Octave-Mechatronics/Sonar-Radar/arduino-sonar-radar/media/sonar_radar_pcb.png

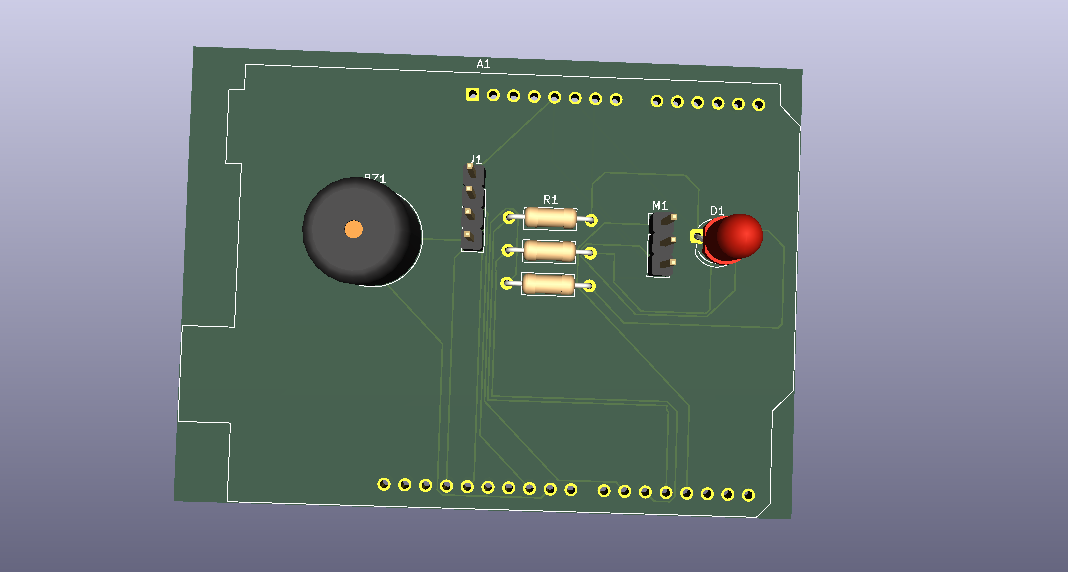
arduino-sonar-radar/media/sonar_radar_pcb.png
