Octave-Mechatronics/Sonar-Radar/sonar_radar_pcb.kicad_pcb

## KiCad design sonar_radar_pcb.kicad_pcb (2026-09-17)

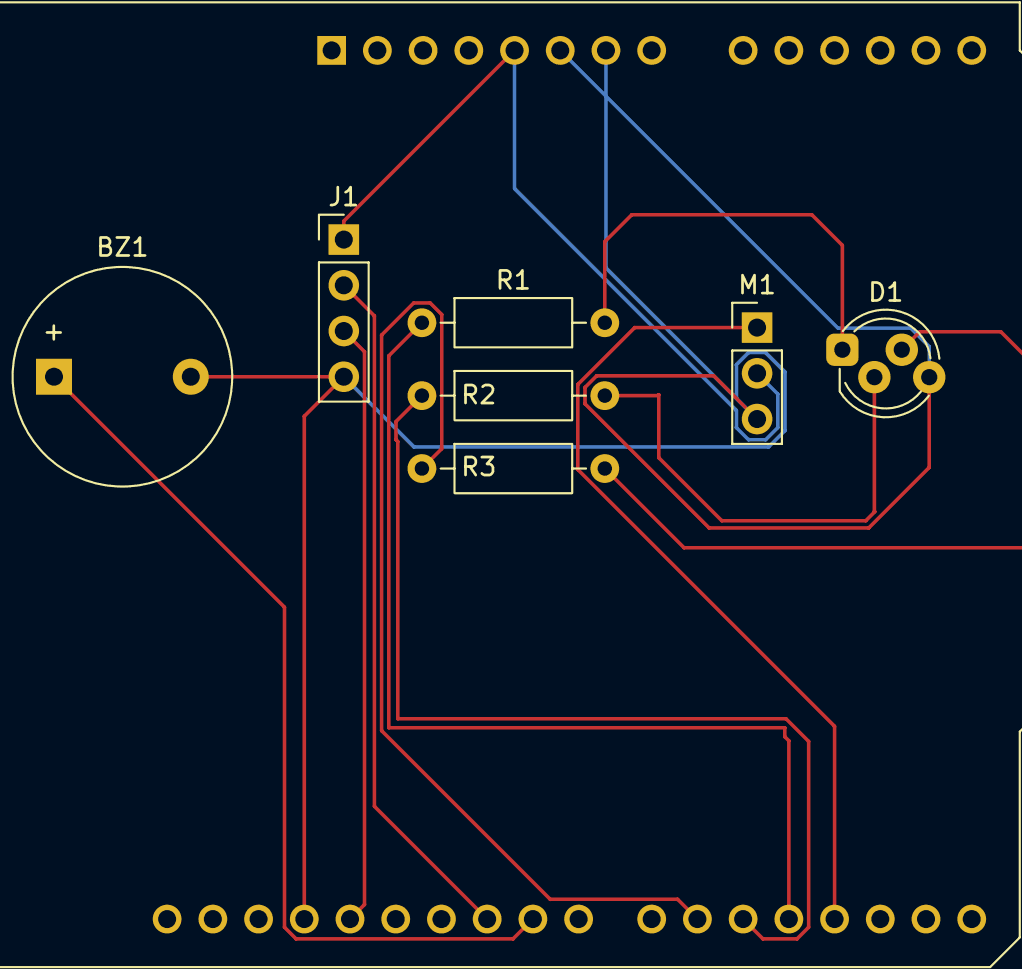
[picture p4: board sonar_radar_pcb.kicad_pcb from above]

Board: 2 copper layers, 8 parts (0 on the bottom side), 12 nets.

Parts:
A1: Arduino_UNO_R3
BZ1: Buzzer; Buzzer_12x9.5RM7.6
D1: LED_RGB; LED_D5.0mm-4_RGB_Staggered_Pins
J1: Conn_01x04; PinHeader_1x04_P2.54mm_Vertical
M1: Motor_Servo; PinHeader_1x03_P2.54mm_Vertical
R1, R2, R3: 220; R_Axial_DIN0207_L6.3mm_D2.5mm_P10.16mm_Horizontal

Connections:
GND: A1.6 (GND), A1.7 (GND), A1.29 (GND), BZ1.2 (-), D1.4 (BA), J1.4, M1.3 (-)
unnamed: A1.5 (+5V), J1.1, M1.2 (+)
unnamed: A1.18 (D3), M1.1 (PWM)
unnamed: A1.19 (D4), R1.1
unnamed: A1.20 (D5), R2.1
unnamed: A1.21 (D6), R3.1
unnamed: A1.24 (D9), BZ1.1 (+)
unnamed: A1.25 (D10), J1.2
unnamed: A1.28 (D13), J1.3
unnamed: D1.3 (BK), R3.2
unnamed: D1.2 (GK), R2.2
unnamed: D1.1 (RK), R1.2
