Octave-Mechatronics/Sonar-Radar/arduino-sonar-radar/results/calibration_curve.png

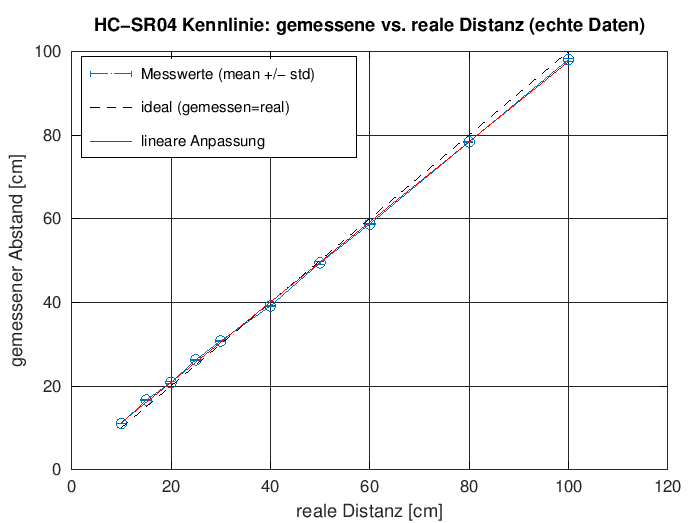
arduino-sonar-radar/results/calibration_curve.png
