Octave-Mechatronics/Sonar-Radar/arduino-sonar-radar/results/calibration_error_analysis.png

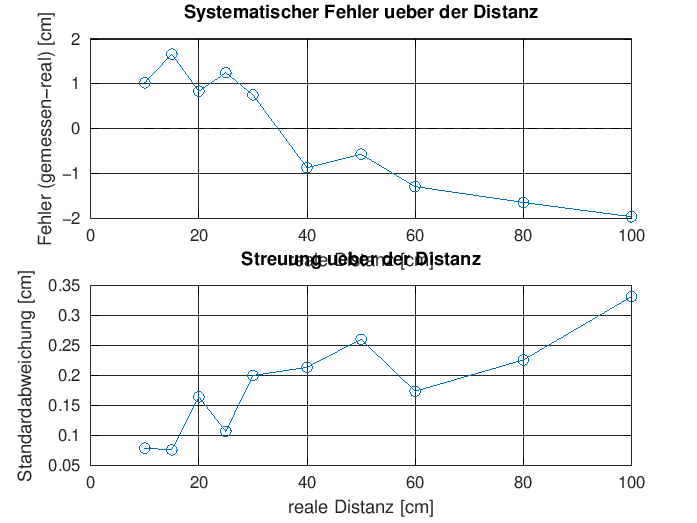
arduino-sonar-radar/results/calibration_error_analysis.png
