Octave-Mechatronics/Sonar-Radar/arduino-sonar-radar/results/characterisation_20cm_histogramm.png

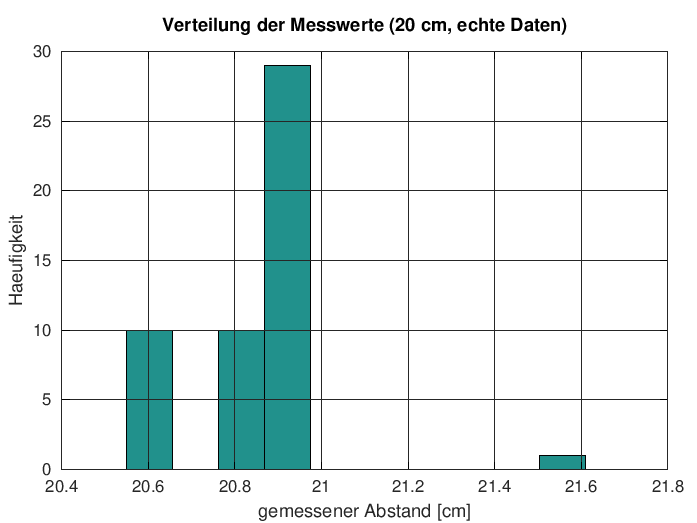
arduino-sonar-radar/results/characterisation_20cm_histogramm.png
