Octave-Mechatronics/Sonar-Radar/arduino-sonar-radar/results/characterisation_20cm_reihe.png

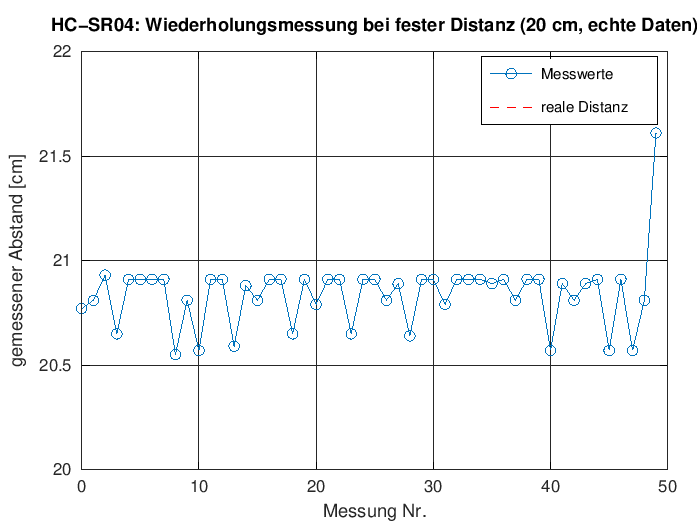
arduino-sonar-radar/results/characterisation_20cm_reihe.png
